cillian64/portfire/README.md

# portfire
Firework ignition control over ethernet

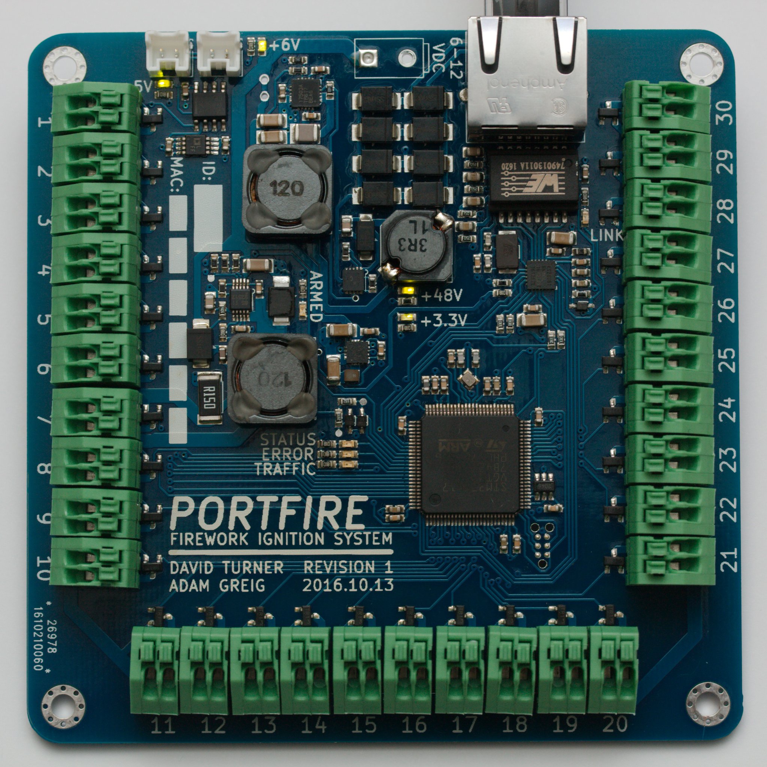
[picture p1: hardware/portfire_photo.jpg]
Photo of PCB


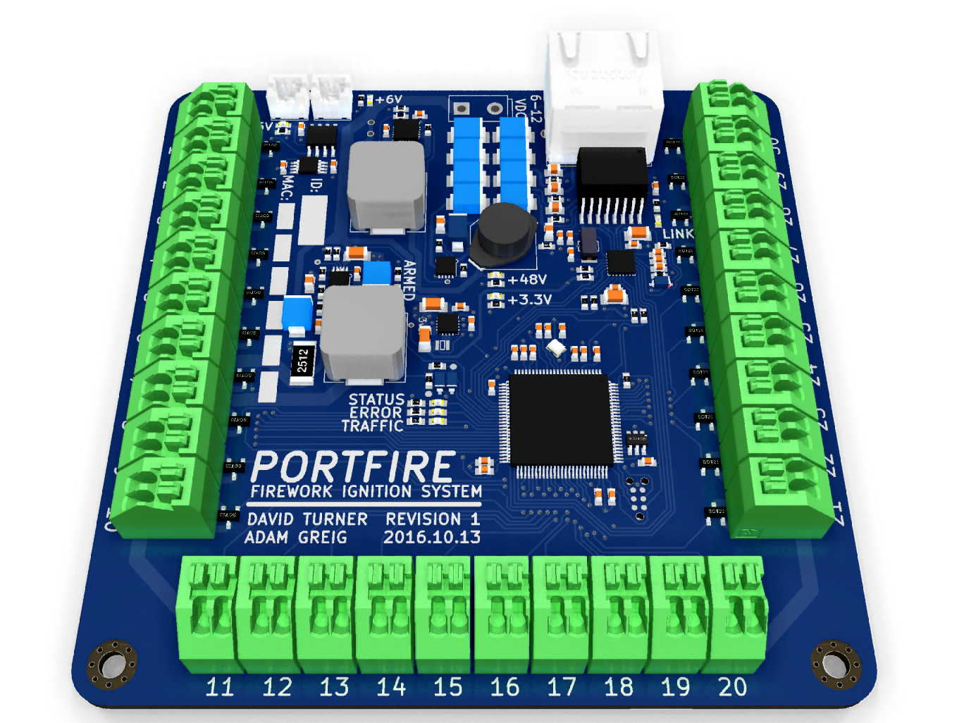
[picture p2: hardware/portfire_render.png]
3d render of PCB
