cillian64/portfire/case/hinged_lid/case_assembled.SLDASM

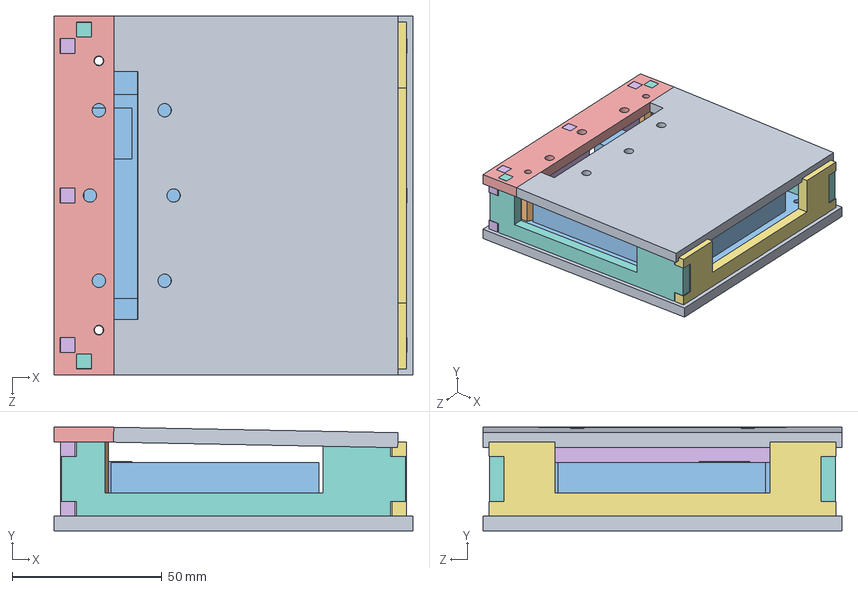
[picture p3: CAD file, 2016-11-16]
case/hinged_lid/case_assembled.SLDASM
120.0 x 34.6 x 120.0 mm
base_plate
hex_pillar x 2
pcb
spacer x 4
top_plate
side_ethernet
side_11-20
side_1-10_and_21-30 x 2
hinged_lid
