cillian64/portfire/case/hinged_lid/plots/side_ethernet.DXF

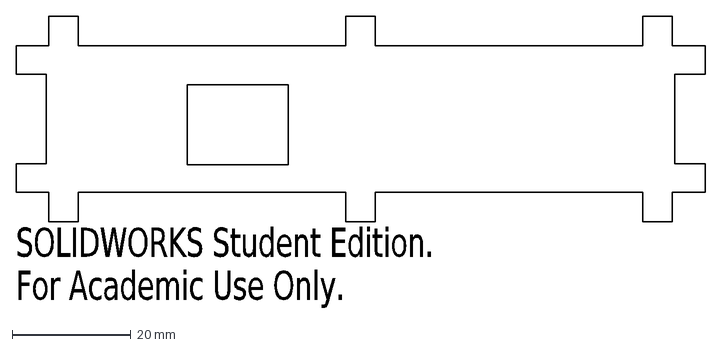
[picture p5: CAD file, 2016-11-16]
case/hinged_lid/plots/side_ethernet.DXF
SOLIDWORKS Student Edition.
For Academic Use Only.
