cillian64/portfire/case/hinged_lid/top_plate.SLDPRT

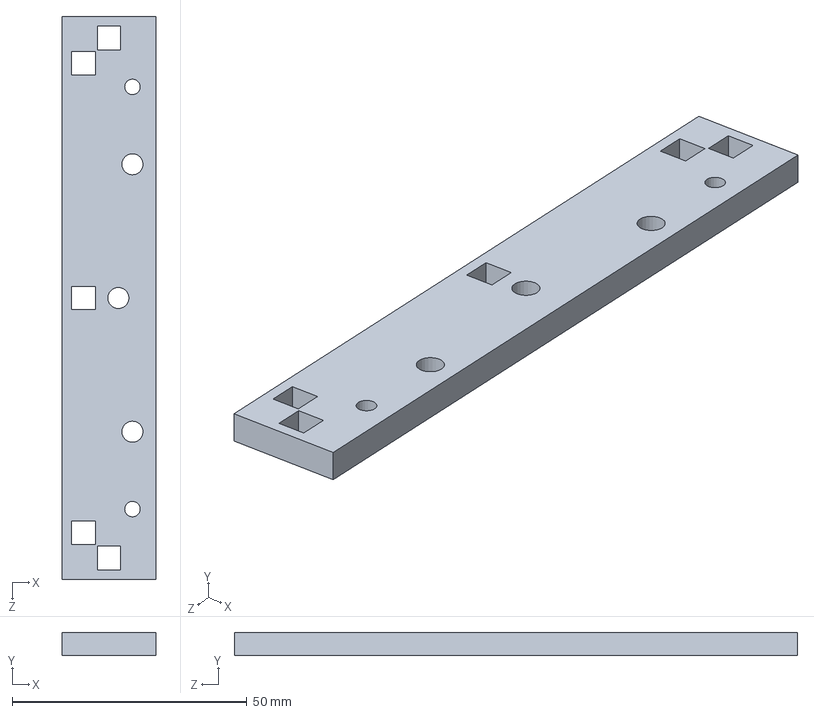
[picture p6: CAD file, 2016-11-16]
case/hinged_lid/top_plate.SLDPRT
20.0 x 5.00 x 120.0 mm
