cillian64/portfire/case/castellated_top/base_plate.SLDPRT

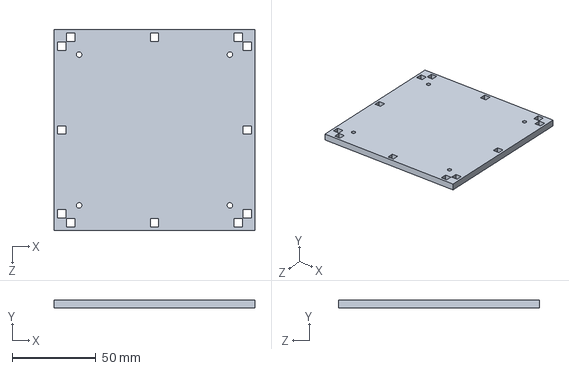
[picture p7: CAD file, 2016-11-12]
case/castellated_top/base_plate.SLDPRT
120.0 x 5.00 x 120.0 mm
