cillian64/portfire/case/hinged_lid/plots/side_11-20.DXF

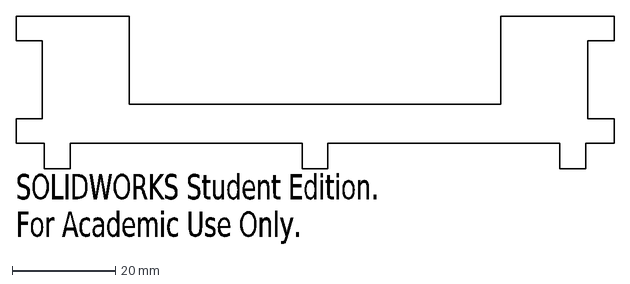
[picture p8: CAD file, 2016-11-16]
case/hinged_lid/plots/side_11-20.DXF
SOLIDWORKS Student Edition.
For Academic Use Only.
