cillian64/portfire/case/castellated_top/side_1-10_and_21-30.SLDPRT

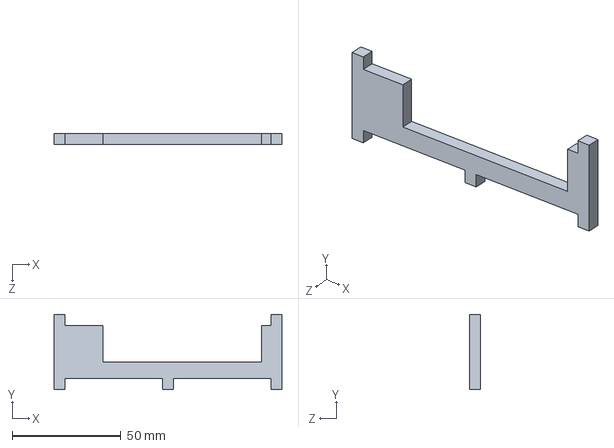
[picture p9: CAD file, 2016-11-12]
case/castellated_top/side_1-10_and_21-30.SLDPRT
105.0 x 34.6 x 5.00 mm
