cillian64/portfire/case/hinged_lid/hinged_lid.SLDPRT

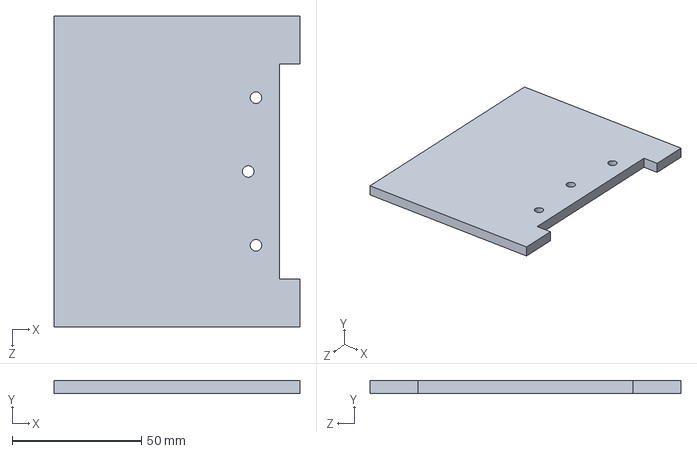
[picture p10: CAD file, 2016-11-16]
case/hinged_lid/hinged_lid.SLDPRT
95.0 x 5.00 x 120.0 mm
