cillian64/portfire/case/hinged_lid/plots/side_1-10_and_21-30.DXF

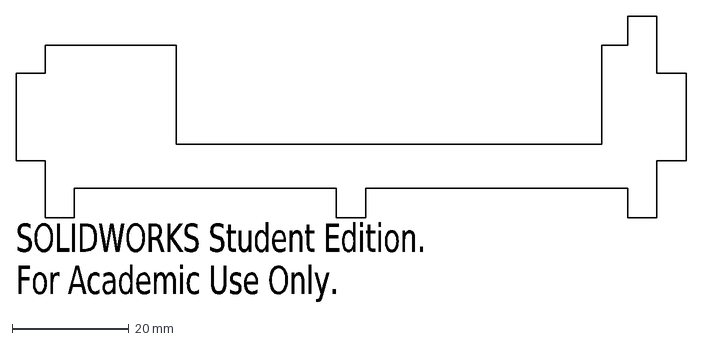
[picture p11: CAD file, 2016-11-16]
case/hinged_lid/plots/side_1-10_and_21-30.DXF
SOLIDWORKS Student Edition.
For Academic Use Only.
