cillian64/portfire/case/castellated_top/side_11-20.SLDPRT

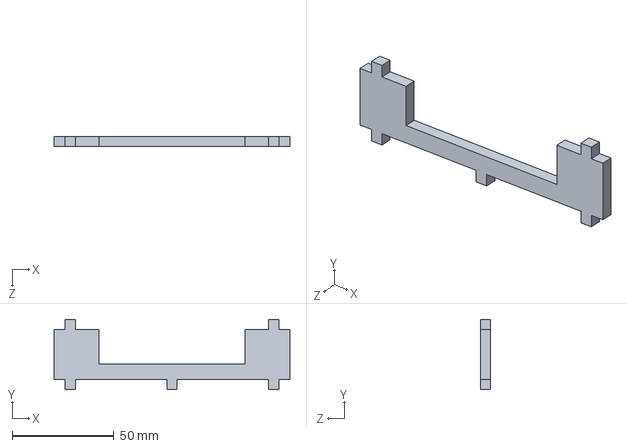
[picture p12: CAD file, 2016-11-12]
case/castellated_top/side_11-20.SLDPRT
116.0 x 34.6 x 5.00 mm
