cillian64/portfire/case/hinged_lid/plots/top_plate.DXF

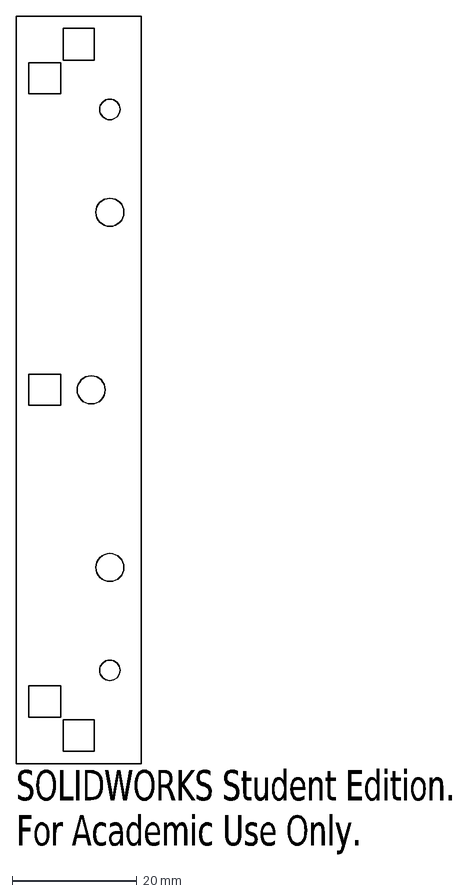
[picture p13: CAD file, 2016-11-16]
case/hinged_lid/plots/top_plate.DXF
SOLIDWORKS Student Edition.
For Academic Use Only.
