cillian64/portfire/case/hinged_lid/side_11-20.SLDPRT

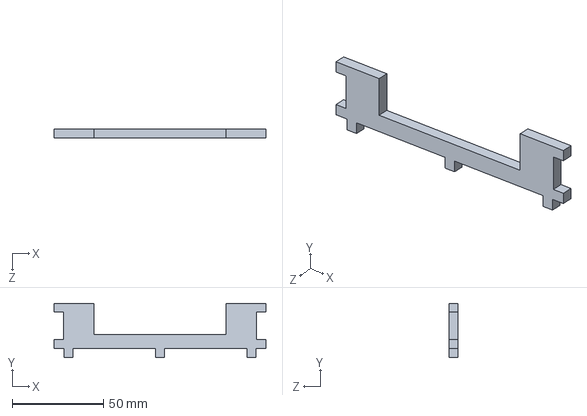
[picture p14: CAD file, 2016-11-12]
case/hinged_lid/side_11-20.SLDPRT
116.0 x 29.6 x 5.00 mm
