cillian64/portfire/case/castellated_top/pcb.SLDPRT

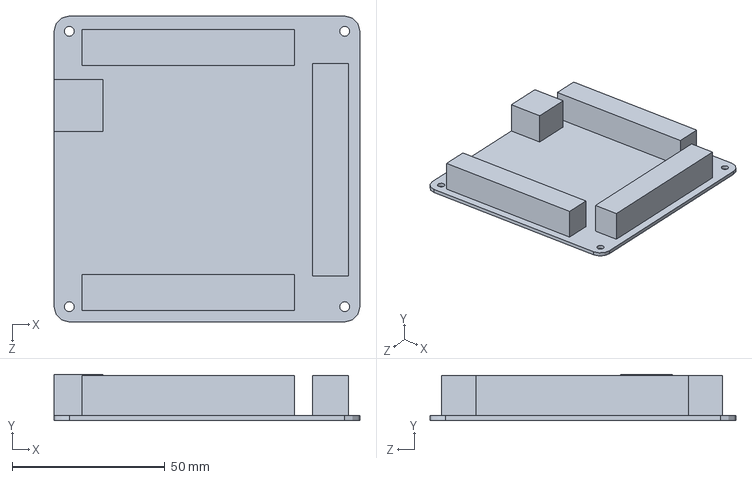
[picture p15: CAD file, 2016-11-12]
case/castellated_top/pcb.SLDPRT
100.0 x 15.1 x 100.0 mm
