cillian64/portfire/case/hinged_lid/plots/base_plate.DXF

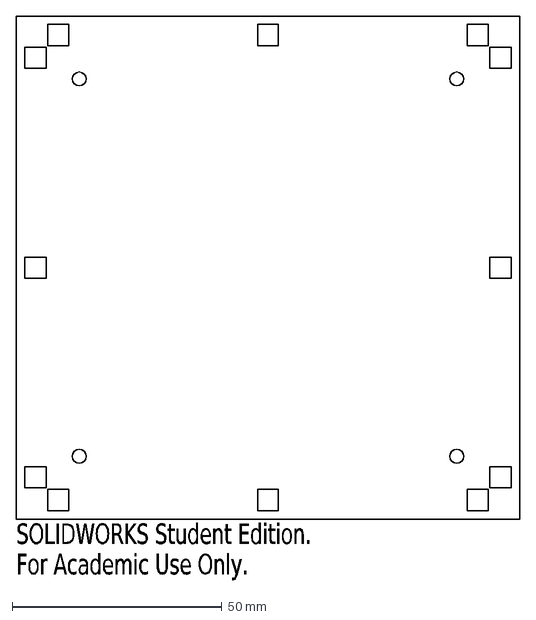
[picture p16: CAD file, 2016-11-16]
case/hinged_lid/plots/base_plate.DXF
SOLIDWORKS Student Edition.
For Academic Use Only.
