cillian64/portfire/case/hinged_lid/side_1-10_and_21-30.SLDPRT

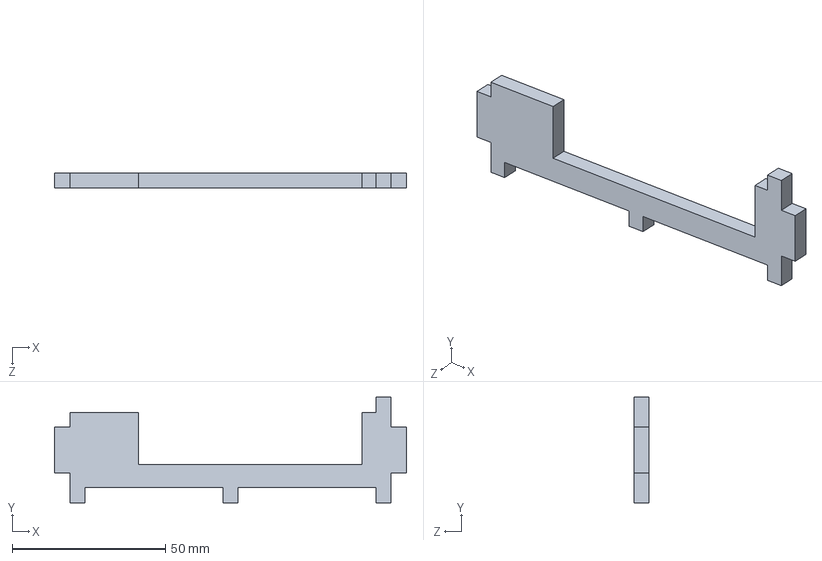
[picture p17: CAD file, 2016-11-12]
case/hinged_lid/side_1-10_and_21-30.SLDPRT
115.0 x 34.6 x 5.00 mm
