cillian64/portfire/case/hinged_lid/plots/hinged_lid.DXF

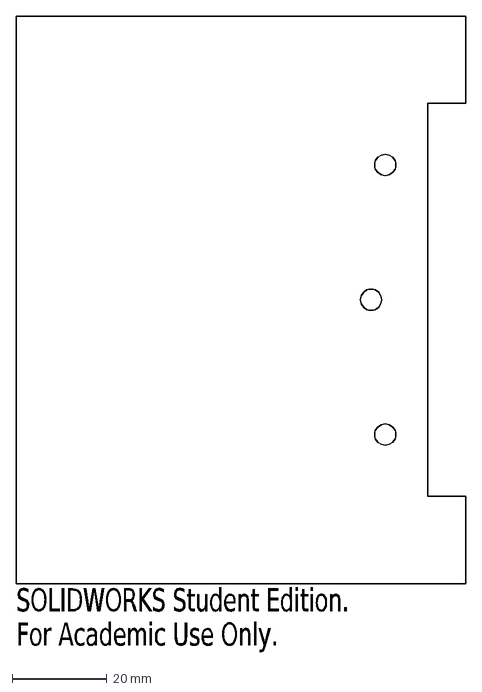
[picture p18: CAD file, 2016-11-16]
case/hinged_lid/plots/hinged_lid.DXF
SOLIDWORKS Student Edition.
For Academic Use Only.
