cillian64/portfire/case/castellated_top/side_ethernet.SLDPRT

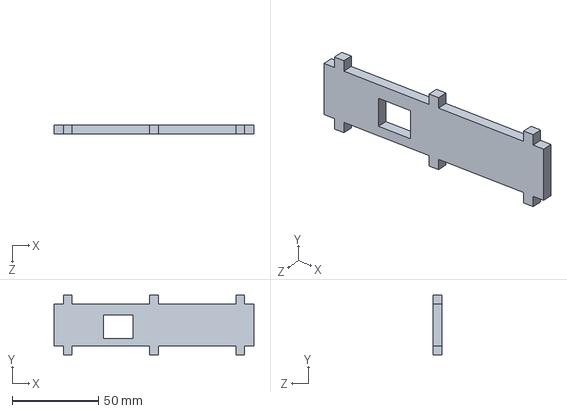
[picture p19: CAD file, 2016-11-12]
case/castellated_top/side_ethernet.SLDPRT
116.0 x 34.6 x 5.00 mm
