cillian64/portfire/case/hinged_lid/spacer.SLDPRT

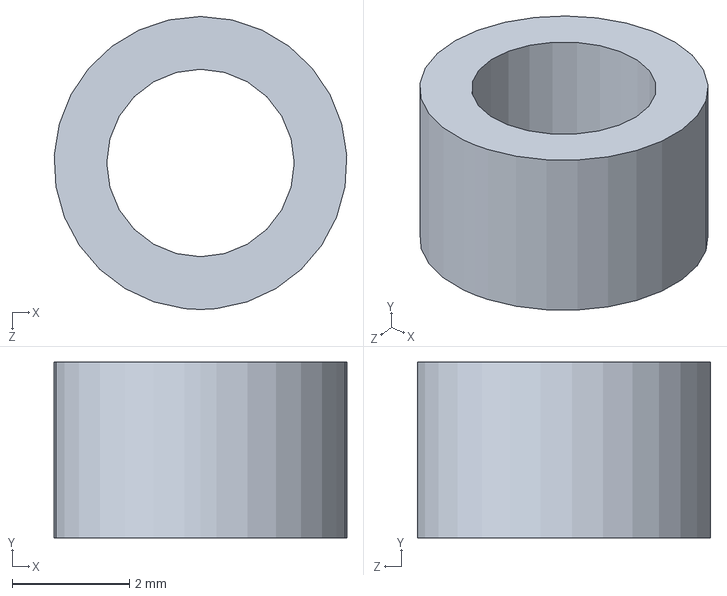
[picture p20: CAD file, 2016-11-12]
case/hinged_lid/spacer.SLDPRT
4.99 x 3.00 x 5.00 mm
