cillian64/portfire/case/hinged_lid/side_ethernet.SLDPRT

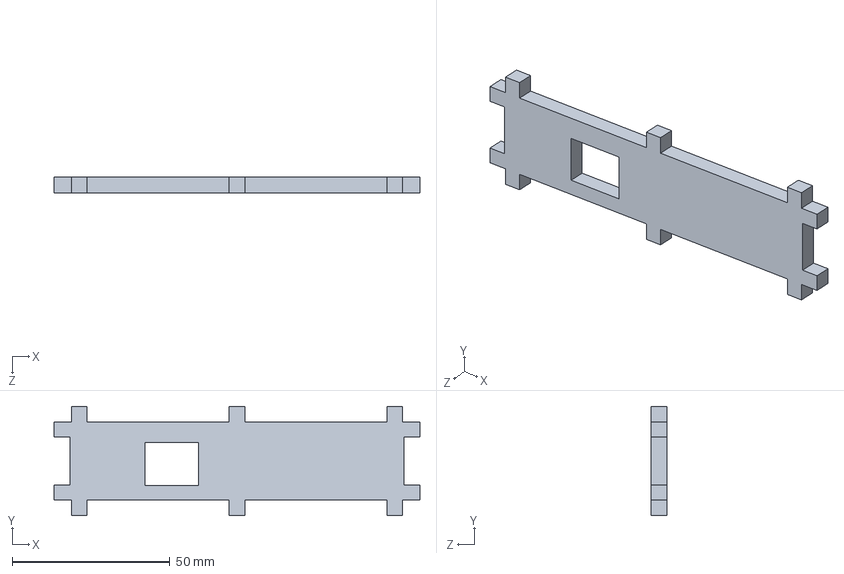
[picture p21: CAD file, 2016-11-12]
case/hinged_lid/side_ethernet.SLDPRT
116.0 x 34.6 x 5.00 mm
