cillian64/portfire/case/castellated_top/hex_pillar.SLDPRT

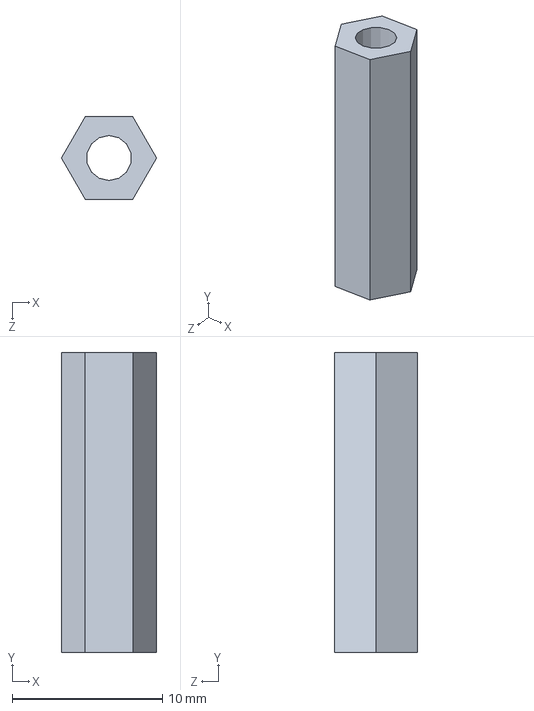
[picture p22: CAD file, 2016-11-12]
case/castellated_top/hex_pillar.SLDPRT
6.35 x 20.0 x 5.50 mm
