cillian64/portfire/(list of files, cad)

Other CAD files:
case/castellated_top/case_assembled.SLDASM
