cillian64/portfire/(threads)

Thread 3 (2016-11-24):

Board 003 doesn't work

adamgreig, 2016-11-24:
Some kind of manufacturing issue suspected.
