cillian64/portfire/hardware/portfire.kicad_pcb

## KiCad design hardware/portfire.kicad_pcb (2016-10-15)

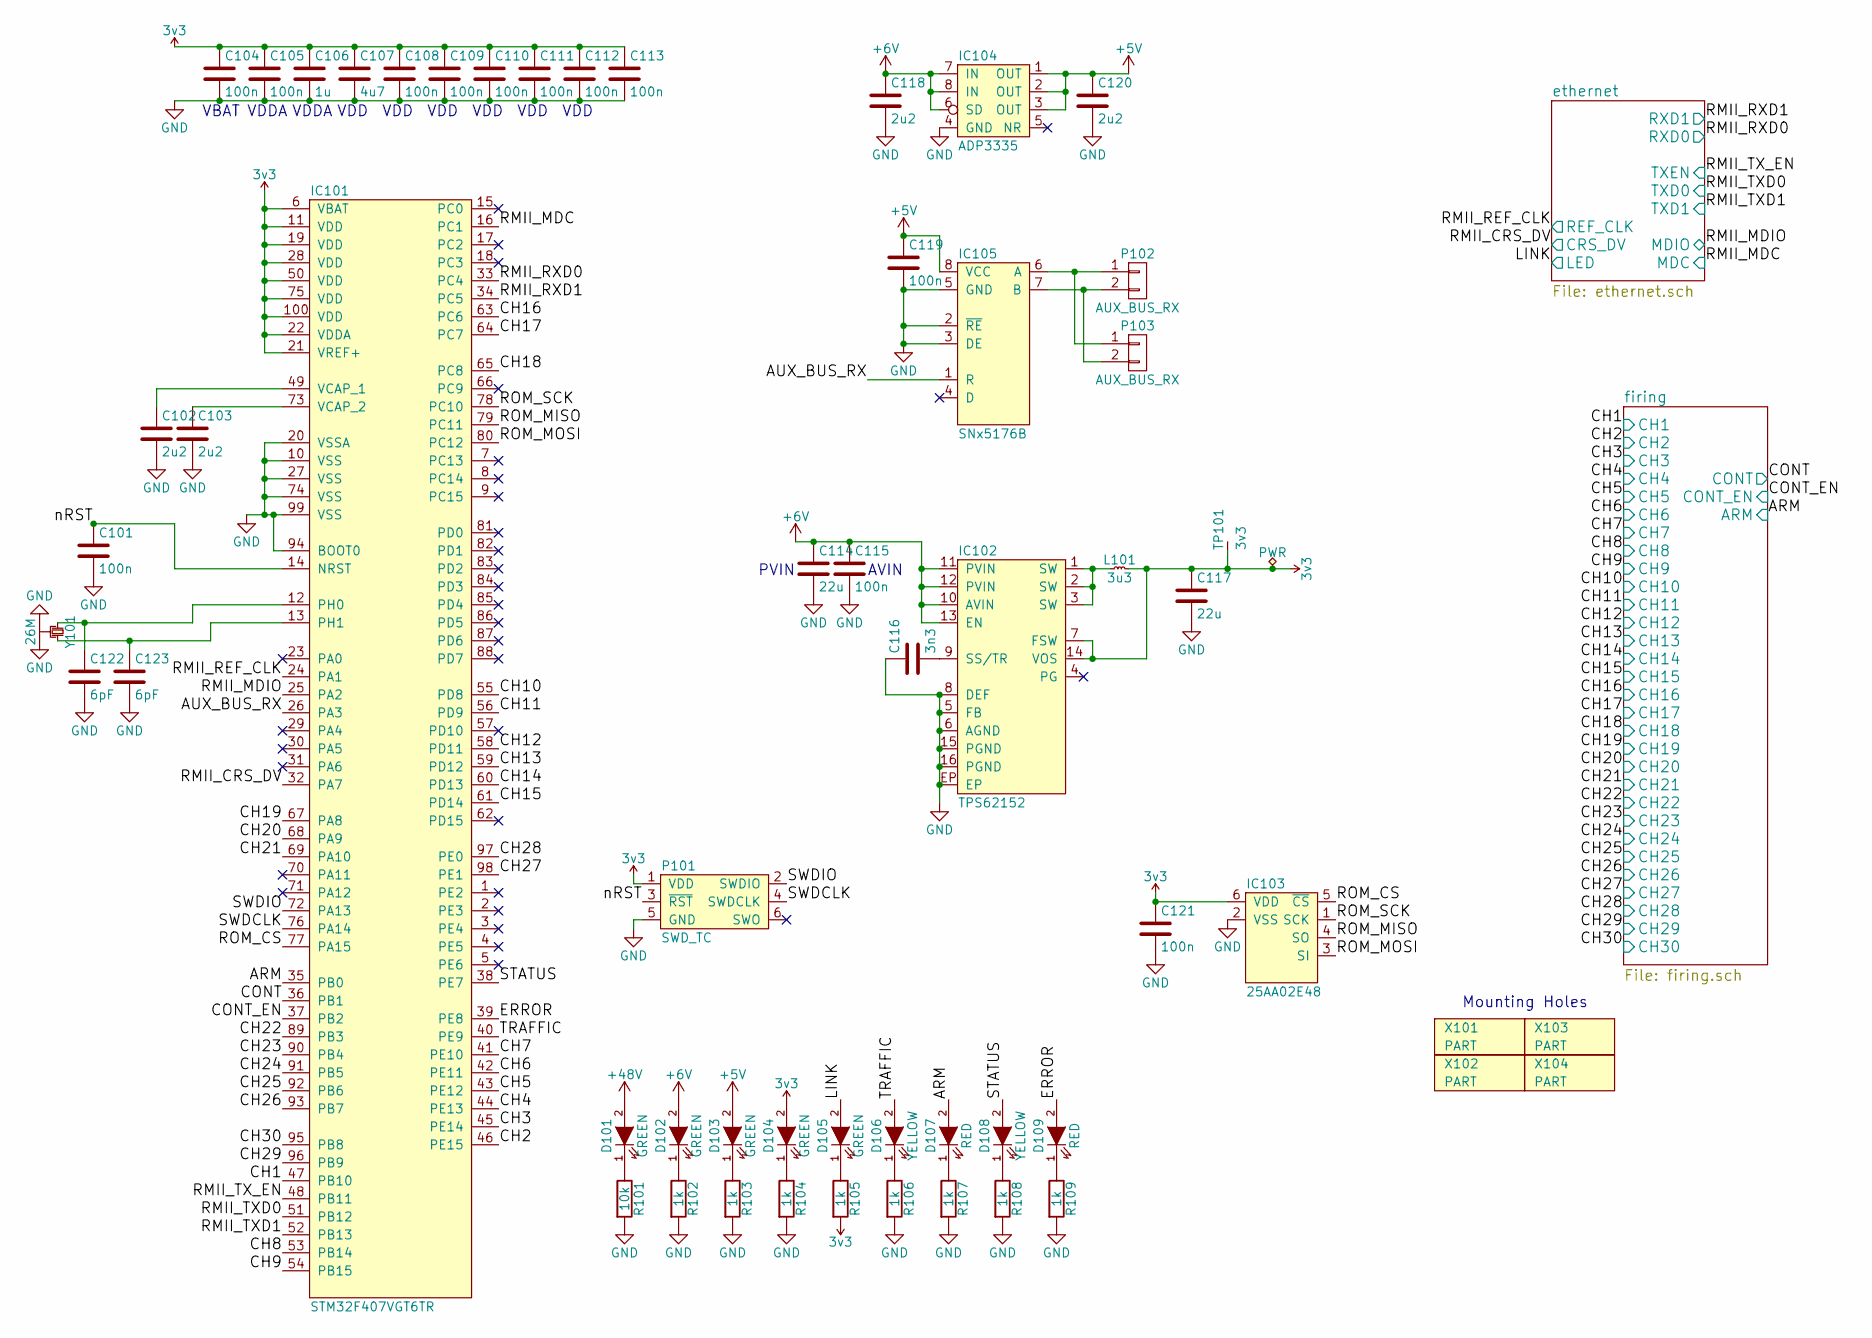
[picture p28: schematic portfire.sch]

Parts:
C101, C104, C105, C108, C109, C110, C111, C112, C113, C115, C119, C121: 100n; 0603; Farnell 1650835
C102, C103, C118, C120: 2u2; 0603; Farnell 2496923
C106: 1u; 0603; Farnell 9227776
C107: 4u7; 0603; Farnell 2496930
C114, C117: 22u; 1206; Farnell 1797010
C116: 3n3; 0603; Farnell 2496853
C122, C123: 6pF; 0603; Farnell 2525074
D101, D102, D103, D104, D105: GREEN; 0603-LED; Farnell 2290328
D106, D108: YELLOW; 0603-LED; Farnell 2290330
D107, D109: RED; 0603-LED; Farnell 2290329
IC101: STM32F407VGT6TR; LQFP-100; Farnell 2333297
IC102: TPS62152; QFN-16-EP-TI; Farnell 2382918
IC103: 25AA02E48; SOT-23-6; Farnell 1700995
IC104: ADP3335; MSOP-8; Farnell 2074873
IC105: SNx5176B; SOIC-8; Farnell 2395904
L101: 3u3; VLS201610HBX-1; Farnell 2455373
P101: SWD_TC; TC2030-NL
P102, P103: AUX_BUS_RX; B02B-PASK; Farnell 1830734
R101: 10k; 0603; Farnell 2303192
R102, R103, R104, R105, R106, R107, R108, R109: 1k; 0603; Farnell 9238484
TP101: 3v3; Test_point_mini
X101, X102, X103, X104: PART; M3_MOUNT
Y101: 26M; XTAL-20x16; Farnell 2455834

Connections:
3v3: C104.1, C105.1, C106.1, C107.1, C108.1, C109.1, C110.1, C111.1, C112.1, C113.1, C117.1, C121.1, D104.2 (A), IC101.6 (VBAT), IC101.11 (VDD), IC101.19 (VDD), IC101.21 (VREF+), IC101.22 (VDDA), IC101.28 (VDD), IC101.50 (VDD), IC101.75 (VDD), IC101.100 (VDD), IC102.7 (FSW), IC102.14 (VOS), IC103.6 (VDD), L101.2, P101.1 (VDD), R105.2, TP101.1; also elsewhere on the board
+5V: C119.1, C120.1, D103.2 (A), IC104.1 (OUT), IC104.2 (OUT), IC104.3 (OUT), IC105.8 (VCC)
+6V: C114.1, C115.1, C118.1, D102.2 (A), IC102.10 (AVIN), IC102.11 (PVIN), IC102.12 (PVIN), IC102.13 (EN), IC104.6 (SD), IC104.7 (IN), IC104.8 (IN); also elsewhere on the board
+48V: D101.2 (A); also elsewhere on the board
/ARM: D107.2 (A), IC101.35 (PB0); also elsewhere on the board
/AUX_BUS_RX: IC101.26 (PA3), IC105.1 (R)
/CH1: IC101.47 (PB10); also elsewhere on the board
/CH2: IC101.46 (PE15); also elsewhere on the board
/CH3: IC101.45 (PE14); also elsewhere on the board
/CH4: IC101.44 (PE13); also elsewhere on the board
/CH5: IC101.43 (PE12); also elsewhere on the board
/CH6: IC101.42 (PE11); also elsewhere on the board
/CH7: IC101.41 (PE10); also elsewhere on the board
/CH8: IC101.53 (PB14); also elsewhere on the board
/CH9: IC101.54 (PB15); also elsewhere on the board
/CH10: IC101.55 (PD8); also elsewhere on the board
/CH11: IC101.56 (PD9); also elsewhere on the board
/CH12: IC101.58 (PD11); also elsewhere on the board
/CH13: IC101.59 (PD12); also elsewhere on the board
/CH14: IC101.60 (PD13); also elsewhere on the board
/CH15: IC101.61 (PD14); also elsewhere on the board
/CH16: IC101.63 (PC6); also elsewhere on the board
/CH17: IC101.64 (PC7); also elsewhere on the board
/CH18: IC101.65 (PC8); also elsewhere on the board
/CH19: IC101.67 (PA8); also elsewhere on the board
/CH20: IC101.68 (PA9); also elsewhere on the board
/CH21: IC101.69 (PA10); also elsewhere on the board
/CH22: IC101.89 (PB3); also elsewhere on the board
/CH23: IC101.90 (PB4); also elsewhere on the board
/CH24: IC101.91 (PB5); also elsewhere on the board
/CH25: IC101.92 (PB6); also elsewhere on the board
/CH26: IC101.93 (PB7); also elsewhere on the board
/CH27: IC101.98 (PE1); also elsewhere on the board
/CH28: IC101.97 (PE0); also elsewhere on the board
/CH29: IC101.96 (PB9); also elsewhere on the board
/CH30: IC101.95 (PB8); also elsewhere on the board
/CONT: IC101.36 (PB1); also elsewhere on the board
/CONT_EN: IC101.37 (PB2); also elsewhere on the board
/ERROR: D109.2 (A), IC101.39 (PE8)
/LINK: D105.2 (A); also elsewhere on the board
/RMII_CRS_DV: IC101.32 (PA7); also elsewhere on the board
/RMII_MDC: IC101.16 (PC1); also elsewhere on the board
/RMII_MDIO: IC101.25 (PA2); also elsewhere on the board
/RMII_REF_CLK: IC101.24 (PA1); also elsewhere on the board
/RMII_RXD0: IC101.33 (PC4); also elsewhere on the board
/RMII_RXD1: IC101.34 (PC5); also elsewhere on the board
/RMII_TXD0: IC101.51 (PB12); also elsewhere on the board
/RMII_TXD1: IC101.52 (PB13); also elsewhere on the board
/RMII_TX_EN: IC101.48 (PB11); also elsewhere on the board
/ROM_CS: IC101.77 (PA15), IC103.5 (~CS)
/ROM_MISO: IC101.79 (PC11), IC103.4 (SO)
/ROM_MOSI: IC101.80 (PC12), IC103.3 (SI)
/ROM_SCK: IC101.78 (PC10), IC103.1 (SCK)
/STATUS: D108.2 (A), IC101.38 (PE7)
/SWDCLK: IC101.76 (PA14), P101.4 (SWDCLK)
/SWDIO: IC101.72 (PA13), P101.2 (SWDIO)
/TRAFFIC: D106.2 (A), IC101.40 (PE9)
/nRST: C101.1, IC101.14 (NRST), P101.3 (~RST)
GND: C101.2, C102.2, C103.2, C104.2, C105.2, C106.2, C107.2, C108.2, C109.2, C110.2, C111.2, C112.2, C113.2, C114.2, C115.2, C116.1, C117.2, C118.2, C119.2, C120.2, C121.2, C122.2, C123.2, IC101.10 (VSS), IC101.20 (VSSA), IC101.27 (VSS), IC101.74 (VSS), IC101.94 (BOOT0), IC101.99 (VSS), IC102.5 (FB), IC102.6 (AGND), IC102.8 (DEF), IC102.15 (PGND), IC102.16 (PGND), IC102.EP, IC103.2 (VSS), IC104.4 (GND), IC105.2 (~RE), IC105.3 (DE), IC105.5 (GND), P101.5 (GND), R101.2, R102.2, R103.2, R104.2, R106.2, R107.2, R108.2, R109.2, Y101.2, Y101.4; also elsewhere on the board
unnamed: C102.1, IC101.49 (VCAP_1)
unnamed: C103.1, IC101.73 (VCAP_2)
unnamed: C116.2, IC102.9 (SS/TR)
unnamed: C122.1, IC101.12 (PH0), Y101.1
unnamed: C123.1, IC101.13 (PH1), Y101.3
unnamed: D101.1 (K), R101.1
unnamed: D102.1 (K), R102.1
unnamed: D103.1 (K), R103.1
unnamed: D104.1 (K), R104.1
unnamed: D105.1 (K), R105.1
unnamed: D106.1 (K), R106.1
unnamed: D107.1 (K), R107.1
unnamed: D108.1 (K), R108.1
unnamed: D109.1 (K), R109.1
unnamed: IC102.1 (SW), IC102.2 (SW), IC102.3 (SW), L101.1
unnamed: IC105.6 (A), P102.1, P103.1
unnamed: IC105.7 (B), P102.2, P103.2

Notes on the sheet:
PVIN
AVIN
VBAT
VDDA
VDD
Mounting Holes

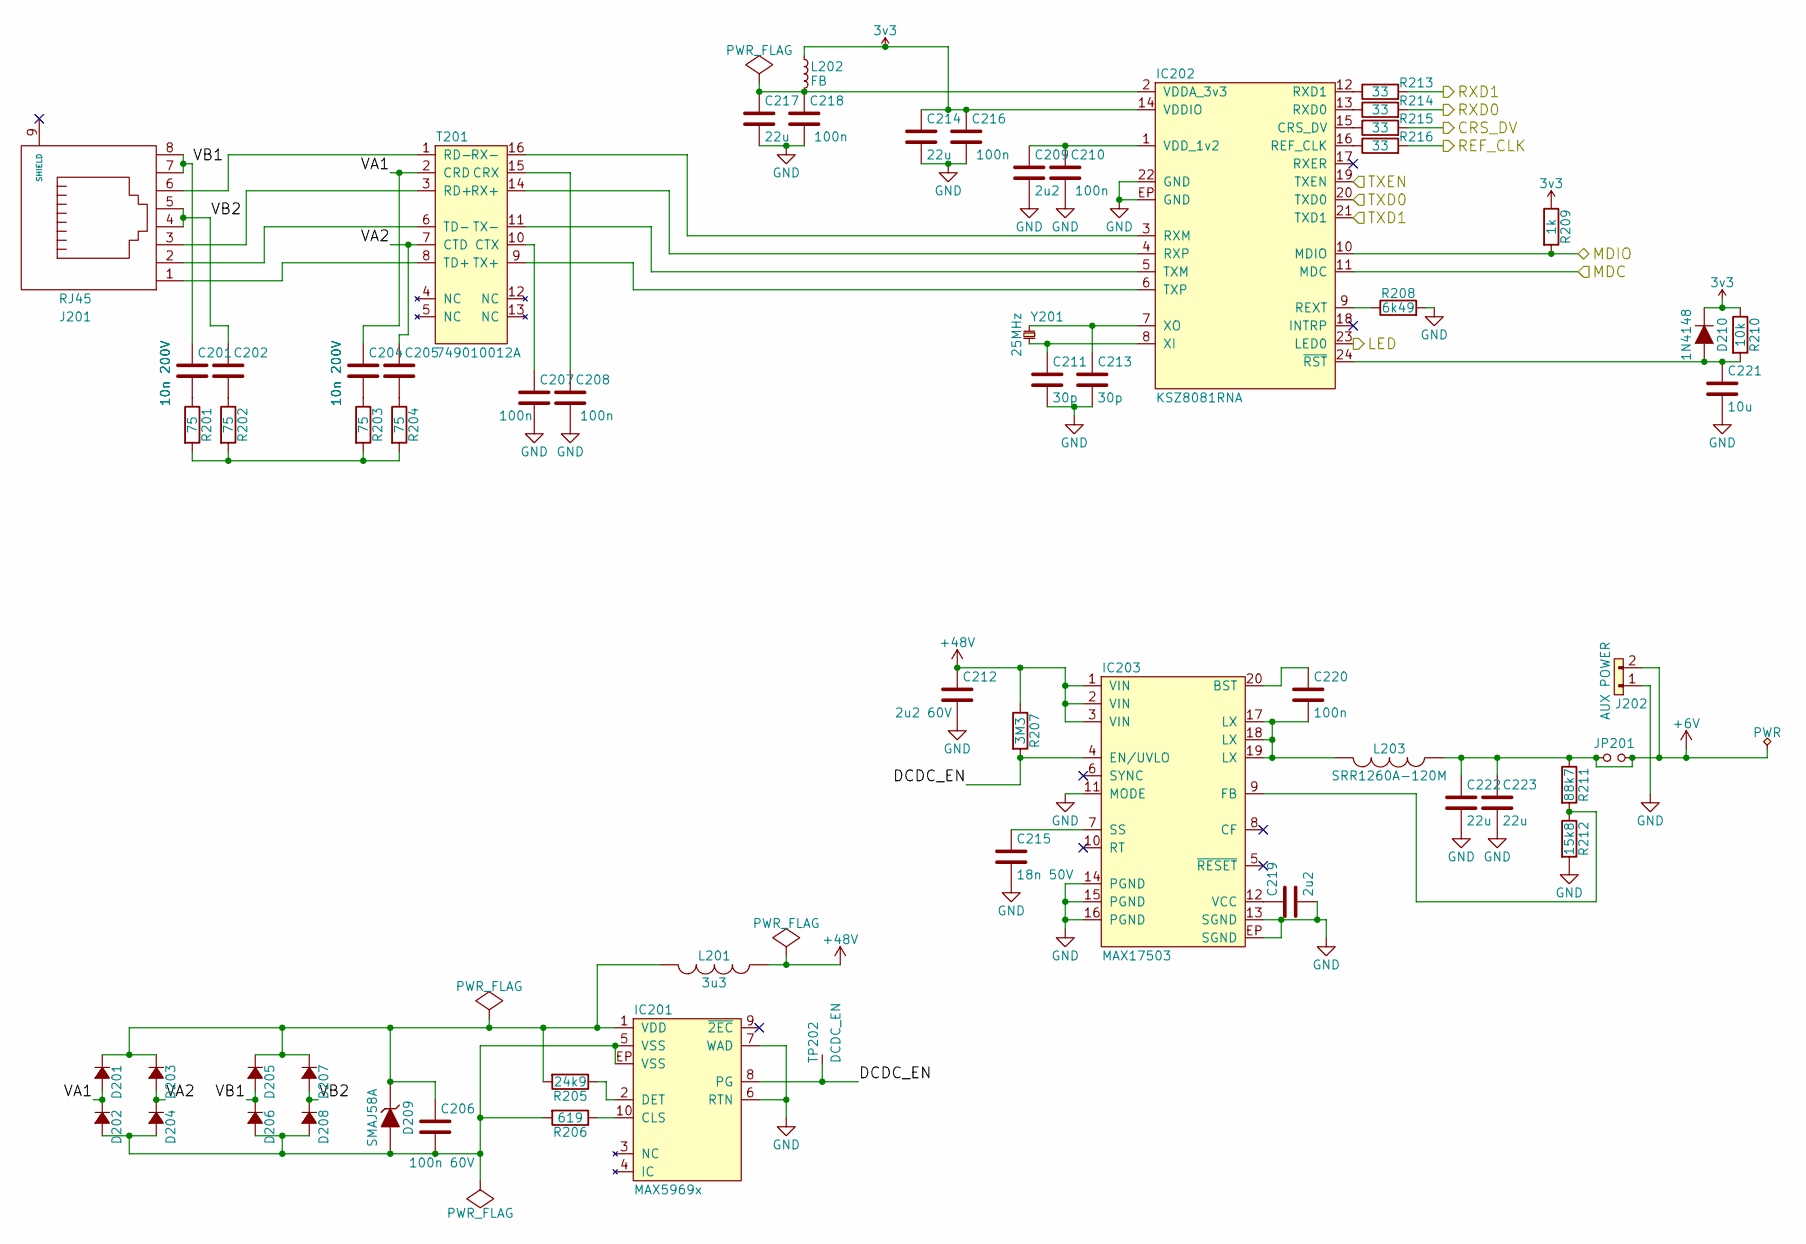
[picture p29: schematic ethernet.sch, Portfire]

Parts:
C201, C202, C204, C205: 10n 200V; 0805; Farnell 1828955
C206: 100n 60V; 0805; Farnell 2496941
C207, C208, C210, C216, C218, C220: 100n; 0603; Farnell 1650835
C209, C219: 2u2; 0603; Farnell 2496923
C211, C213: 30p; 0603; Farnell 2524889
C212: 2u2 60V; 1210; Farnell 1793832
C214, C217, C222, C223: 22u; 1206; Farnell 1797010
C215: 18n 50V; 0603; Farnell 1865536
C221: 10u; 0603; Farnell 2611921
D201, D202, D203, D204, D205, D206, D207, D208: SS110B; DO-214AA-SMB; Farnell 1861422
D209: SMAJ58A; DO-214AC-SMA; Farnell 1899460
D210: 1N4148; SOD-323; Farnell 1466524
IC201: MAX5969x; DFN-10-EP-MAX; Farnell 2514586
IC202: KSZ8081RNA; QFN-24-EP-MICREL; Farnell 2509802
IC203: MAX17503; QFN-20-EP-MAX; Farnell 2514229
J201: RJ45; RJHSE5380; Farnell 1860580
J202: AUX POWER; Minipow; Farnell CN13861
JP201: Jumper_NO_Small; jump
L201: 3u3; ELLATP3R3NB; Farnell 1865686
L202: FB; 0603; Farnell 1463451
L203: SRR1260A-120M; SRR1260A; Farnell 2374123
R201, R202, R203, R204: 75; 0603; Farnell 2059571
R205: 24k9; 0603; Farnell 2059450
R206: 619; 0603; Farnell 2059317
R207: 3M3; 0603; Farnell 2138666
R208: 6k49; 0603; Farnell 2059389
R209: 1k; 0603; Farnell 9238484
R210: 10k; 0603; Farnell 2303192
R211: 88k7; 0603; Farnell 2059491
R212: 15k8; 0603; Farnell 2138432
R213, R214, R215, R216: 33; 0603; Farnell 2059561
T201: 749010012A; Farnell 2422552
TP202: DCDC_EN; Test_point_mini
Y201: 25MHz; XTAL-50x32; Farnell 2101328

Connections:
3v3: C214.1, C216.1, D210.1 (K), IC202.14 (VDDIO), L202.1, R209.1, R210.1; also elsewhere on the board
+6V: C222.1, C223.1, J202.2, JP201.1, JP201.2, L203.1, R211.1; also elsewhere on the board
+48V: C212.1, IC203.1 (VIN), IC203.2 (VIN), IC203.3 (VIN), L201.1, R207.1; also elsewhere on the board
/LINK: IC202.23 (LED0); also elsewhere on the board
/RMII_CRS_DV: R215.2; also elsewhere on the board
/RMII_MDC: IC202.11 (MDC); also elsewhere on the board
/RMII_MDIO: IC202.10 (MDIO), R209.2; also elsewhere on the board
/RMII_REF_CLK: R216.2; also elsewhere on the board
/RMII_RXD0: R214.2; also elsewhere on the board
/RMII_RXD1: R213.2; also elsewhere on the board
/RMII_TXD0: IC202.20 (TXD0); also elsewhere on the board
/RMII_TXD1: IC202.21 (TXD1); also elsewhere on the board
/RMII_TX_EN: IC202.19 (TXEN); also elsewhere on the board
/ethernet/DCDC_EN: IC201.8 (PG), IC203.4 (EN/UVLO), R207.2, TP202.1
/ethernet/VA1: C204.1, D201.2 (A), D202.1 (K), T201.2 (CRD)
/ethernet/VA2: C205.1, D203.2 (A), D204.1 (K), T201.7 (CTD)
/ethernet/VB1: C201.1, D205.2 (A), D206.1 (K), J201.7, J201.8
/ethernet/VB2: C202.1, D207.2 (A), D208.1 (K), J201.4, J201.5
GND: C207.2, C208.2, C209.2, C210.2, C211.2, C212.2, C213.2, C214.2, C215.2, C216.2, C217.2, C218.2, C219.2, C221.2, C222.2, C223.2, IC201.6 (RTN), IC201.7 (WAD), IC202.22 (GND), IC202.EP (GND), IC203.11 (MODE), IC203.13 (SGND), IC203.14 (PGND), IC203.15 (PGND), IC203.16 (PGND), IC203.EP (SGND), J202.1, R208.2, R212.2; also elsewhere on the board
unnamed: C201.2, R201.1
unnamed: C202.2, R202.1
unnamed: C204.2, R203.1
unnamed: C205.2, R204.1
unnamed: C206.1, D201.1 (K), D203.1 (K), D205.1 (K), D207.1 (K), D209.1 (K), IC201.1 (VDD), L201.2, R205.2
unnamed: C206.2, D202.2 (A), D204.2 (A), D206.2 (A), D208.2 (A), D209.2 (A), IC201.5 (VSS), IC201.EP (VSS), R206.2
unnamed: C207.1, T201.10 (CTX)
unnamed: C208.1, T201.15 (CRX)
unnamed: C209.1, C210.1, IC202.1 (VDD_1v2)
unnamed: C211.1, IC202.8 (XI), Y201.2
unnamed: C213.1, IC202.7 (XO), Y201.1
unnamed: C215.1, IC203.7 (SS)
unnamed: C217.1, C218.1, IC202.2 (VDDA_3v3), L202.2
unnamed: C219.1, IC203.12 (VCC)
unnamed: C220.1, IC203.20 (BST)
unnamed: C220.2, IC203.17 (LX), IC203.18 (LX), IC203.19 (LX), L203.2
unnamed: C221.1, D210.2 (A), IC202.24 (~RST), R210.2
unnamed: IC201.2 (DET), R205.1
unnamed: IC201.10 (CLS), R206.1
unnamed: IC202.3 (RXM), T201.16 (RX-)
unnamed: IC202.4 (RXP), T201.14 (RX+)
unnamed: IC202.5 (TXM), T201.11 (TX-)
unnamed: IC202.6 (TXP), T201.9 (TX+)
unnamed: IC202.9 (REXT), R208.1
unnamed: IC202.12 (RXD1), R213.1
unnamed: IC202.13 (RXD0), R214.1
unnamed: IC202.15 (CRS_DV), R215.1
unnamed: IC202.16 (REF_CLK), R216.1
unnamed: IC203.9 (FB), R211.2, R212.1
unnamed: J201.1, T201.8 (TD+)
unnamed: J201.2, T201.6 (TD-)
unnamed: J201.3, T201.3 (RD+)
unnamed: J201.6, T201.1 (RD-)
unnamed: R201.2, R202.2, R203.2, R204.2

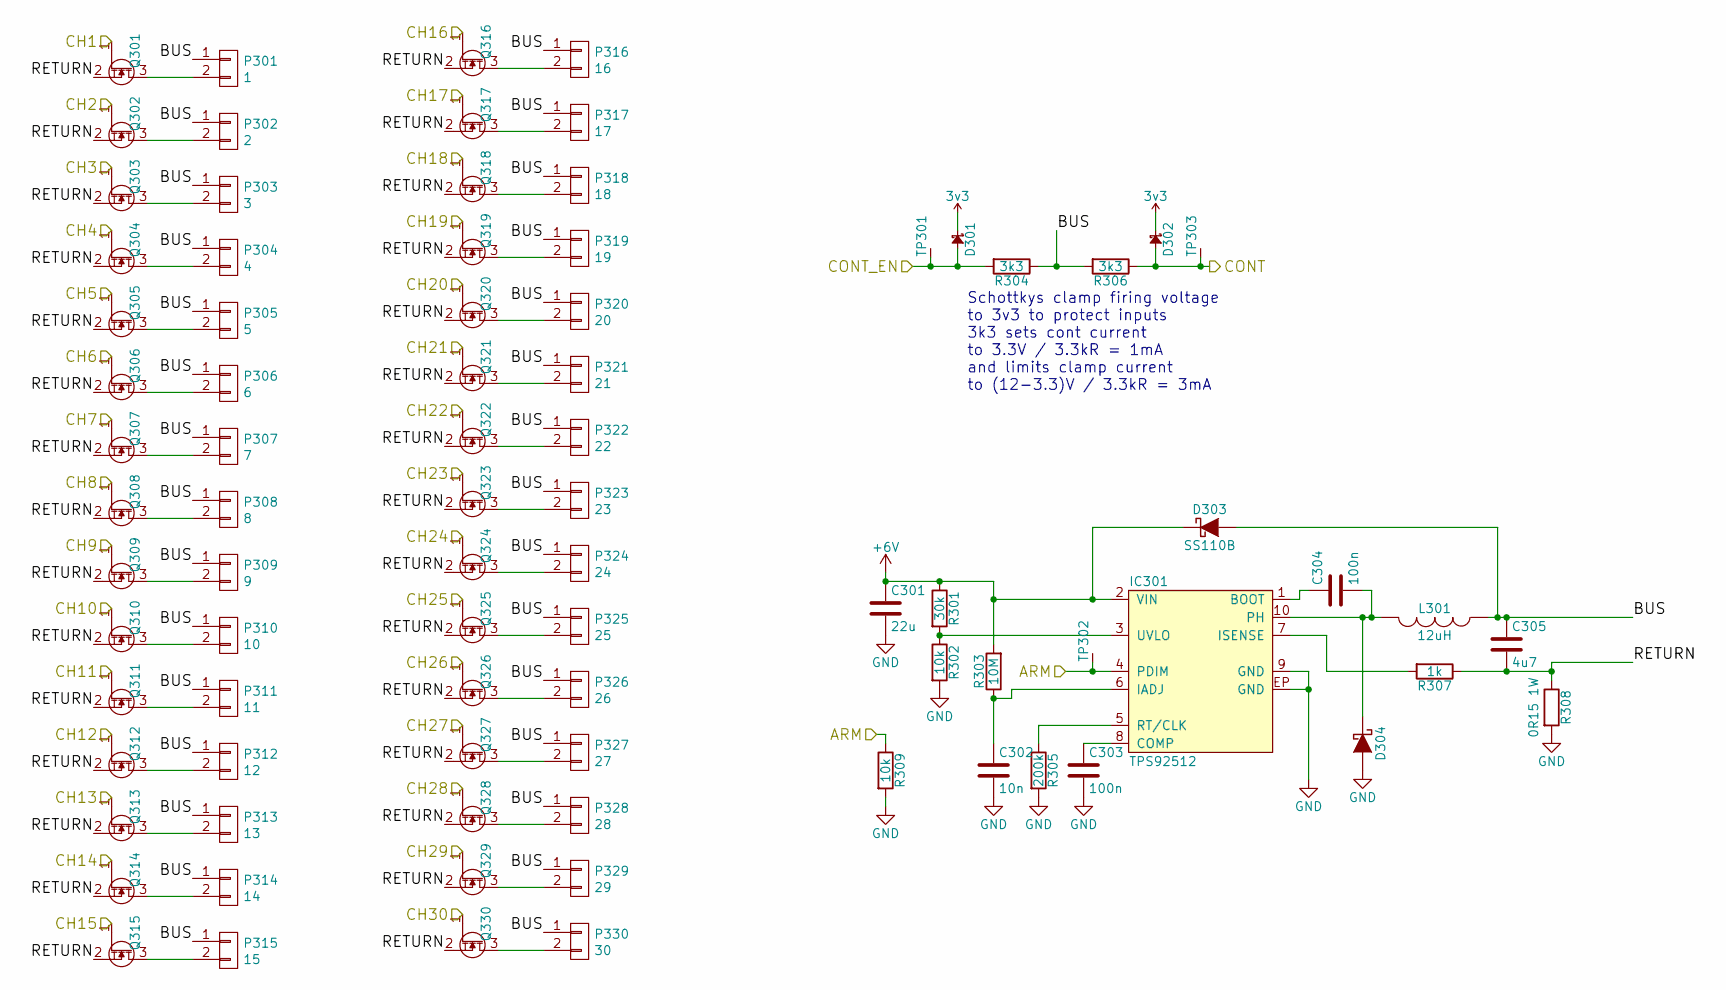
[picture p30: schematic firing.sch, Portfire]

Parts:
C301: 22u; 1206; Farnell 1797010
C302: 10n; 0805; Farnell 1828955
C303, C304: 100n; 0603; Farnell 1650835
C305: 4u7; 0603; Farnell 2525102
D301, D302: PMEG2005AEA; SOD-323; Farnell 8737843
D303: SS110B; DO-214AA-SMB; Farnell 1861422
D304: STPS3L40UF; DO-214AA-SMB; Farnell 2341599
IC301: TPS92512; MSOP-10-EP-TI; Farnell 2471141
L301: 12uH; SRR1260A; Farnell 2374123
P301: 1; PTSA0,52-2,5-z; Farnell 1792951
P302: 2; PTSA0,52-2,5-z; Farnell 1792951
P303: 3; PTSA0,52-2,5-z; Farnell 1792951
P304: 4; PTSA0,52-2,5-z; Farnell 1792951
P305: 5; PTSA0,52-2,5-z; Farnell 1792951
P306: 6; PTSA0,52-2,5-z; Farnell 1792951
P307: 7; PTSA0,52-2,5-z; Farnell 1792951
P308: 8; PTSA0,52-2,5-z; Farnell 1792951
P309: 9; PTSA0,52-2,5-z; Farnell 1792951
P310: 10; PTSA0,52-2,5-z; Farnell 1792951
P311: 11; PTSA0,52-2,5-z; Farnell 1792951
P312: 12; PTSA0,52-2,5-z; Farnell 1792951
P313: 13; PTSA0,52-2,5-z; Farnell 1792951
P314: 14; PTSA0,52-2,5-z; Farnell 1792951
P315: 15; PTSA0,52-2,5-z; Farnell 1792951
P316: 16; PTSA0,52-2,5-z; Farnell 1792951
P317: 17; PTSA0,52-2,5-z; Farnell 1792951
P318: 18; PTSA0,52-2,5-z; Farnell 1792951
P319: 19; PTSA0,52-2,5-z; Farnell 1792951
P320: 20; PTSA0,52-2,5-z; Farnell 1792951
P321: 21; PTSA0,52-2,5-z; Farnell 1792951
P322: 22; PTSA0,52-2,5-z; Farnell 1792951
P323: 23; PTSA0,52-2,5-z; Farnell 1792951
P324: 24; PTSA0,52-2,5-z; Farnell 1792951
P325: 25; PTSA0,52-2,5-z; Farnell 1792951
P326: 26; PTSA0,52-2,5-z; Farnell 1792951
P327: 27; PTSA0,52-2,5-z; Farnell 1792951
P328: 28; PTSA0,52-2,5-z; Farnell 1792951
P329: 29; PTSA0,52-2,5-z; Farnell 1792951
P330: 30; PTSA0,52-2,5-z; Farnell 1792951
Q301, Q302, Q303, Q304, Q305, Q306, Q307, Q308, Q309, Q310, Q311, Q312, Q313, Q314, Q315, Q316, Q317, Q318, Q319, Q320, Q321, Q322, Q323, Q324, Q325, Q326, Q327, Q328, Q329, Q330: NTR4501NT1G; SOT-23; Farnell 1431305
R301: 30k; 0603; Farnell 2059451
R302, R309: 10k; 0603; Farnell 2303192
R303: 10M; 0603; Farnell 2059699
R304, R306: 3k3; 0603; Farnell 2059614
R305: 200k; 0603; Farnell 2059509
R307: 1k; 0603; Farnell 9238484
R308: 0R15 1W; 2512; Farnell 2116453
TP301: CONT_EN; TESTPAD
TP302: ARM; TESTPAD
TP303: CONT_MEAS; TESTPAD

Connections:
3v3: D301.1, D302.1; also elsewhere on the board
+6V: C301.1, D303.1 (K), IC301.2 (VIN), R301.1, R303.2; also elsewhere on the board
/ARM: IC301.4 (PDIM), R309.1, TP302.1; also elsewhere on the board
/CH1: Q301.1 (G); also elsewhere on the board
/CH2: Q302.1 (G); also elsewhere on the board
/CH3: Q303.1 (G); also elsewhere on the board
/CH4: Q304.1 (G); also elsewhere on the board
/CH5: Q305.1 (G); also elsewhere on the board
/CH6: Q306.1 (G); also elsewhere on the board
/CH7: Q307.1 (G); also elsewhere on the board
/CH8: Q308.1 (G); also elsewhere on the board
/CH9: Q309.1 (G); also elsewhere on the board
/CH10: Q310.1 (G); also elsewhere on the board
/CH11: Q311.1 (G); also elsewhere on the board
/CH12: Q312.1 (G); also elsewhere on the board
/CH13: Q313.1 (G); also elsewhere on the board
/CH14: Q314.1 (G); also elsewhere on the board
/CH15: Q315.1 (G); also elsewhere on the board
/CH16: Q316.1 (G); also elsewhere on the board
/CH17: Q317.1 (G); also elsewhere on the board
/CH18: Q318.1 (G); also elsewhere on the board
/CH19: Q319.1 (G); also elsewhere on the board
/CH20: Q320.1 (G); also elsewhere on the board
/CH21: Q321.1 (G); also elsewhere on the board
/CH22: Q322.1 (G); also elsewhere on the board
/CH23: Q323.1 (G); also elsewhere on the board
/CH24: Q324.1 (G); also elsewhere on the board
/CH25: Q325.1 (G); also elsewhere on the board
/CH26: Q326.1 (G); also elsewhere on the board
/CH27: Q327.1 (G); also elsewhere on the board
/CH28: Q328.1 (G); also elsewhere on the board
/CH29: Q329.1 (G); also elsewhere on the board
/CH30: Q330.1 (G); also elsewhere on the board
/CONT: D302.2, R306.1, TP303.1; also elsewhere on the board
/CONT_EN: D301.2, R304.2, TP301.1; also elsewhere on the board
/firing/BUS: C305.1, D303.2 (A), L301.1, P301.1, P302.1, P303.1, P304.1, P305.1, P306.1, P307.1, P308.1, P309.1, P310.1, P311.1, P312.1, P313.1, P314.1, P315.1, P316.1, P317.1, P318.1, P319.1, P320.1, P321.1, P322.1, P323.1, P324.1, P325.1, P326.1, P327.1, P328.1, P329.1, P330.1, R304.1, R306.2
/firing/RETURN: C305.2, Q301.2 (S), Q302.2 (S), Q303.2 (S), Q304.2 (S), Q305.2 (S), Q306.2 (S), Q307.2 (S), Q308.2 (S), Q309.2 (S), Q310.2 (S), Q311.2 (S), Q312.2 (S), Q313.2 (S), Q314.2 (S), Q315.2 (S), Q316.2 (S), Q317.2 (S), Q318.2 (S), Q319.2 (S), Q320.2 (S), Q321.2 (S), Q322.2 (S), Q323.2 (S), Q324.2 (S), Q325.2 (S), Q326.2 (S), Q327.2 (S), Q328.2 (S), Q329.2 (S), Q330.2 (S), R307.1, R308.1
GND: C301.2, C302.2, C303.2, D304.2 (A), IC301.9 (GND), IC301.EP (GND), R302.2, R305.2, R308.2, R309.2; also elsewhere on the board
unnamed: C302.1, IC301.6 (IADJ), R303.1
unnamed: C303.1, IC301.8 (COMP)
unnamed: C304.1, IC301.1 (BOOT)
unnamed: C304.2, D304.1 (K), IC301.10 (PH), L301.2
unnamed: IC301.3 (UVLO), R301.2, R302.1
unnamed: IC301.5 (RT/CLK), R305.1
unnamed: IC301.7 (ISENSE), R307.2
unnamed: P301.2, Q301.3 (D)
unnamed: P302.2, Q302.3 (D)
unnamed: P303.2, Q303.3 (D)
unnamed: P304.2, Q304.3 (D)
unnamed: P305.2, Q305.3 (D)
unnamed: P306.2, Q306.3 (D)
unnamed: P307.2, Q307.3 (D)
unnamed: P308.2, Q308.3 (D)
unnamed: P309.2, Q309.3 (D)
unnamed: P310.2, Q310.3 (D)
unnamed: P311.2, Q311.3 (D)
unnamed: P312.2, Q312.3 (D)
unnamed: P313.2, Q313.3 (D)
unnamed: P314.2, Q314.3 (D)
unnamed: P315.2, Q315.3 (D)
unnamed: P316.2, Q316.3 (D)
unnamed: P317.2, Q317.3 (D)
unnamed: P318.2, Q318.3 (D)
unnamed: P319.2, Q319.3 (D)
unnamed: P320.2, Q320.3 (D)
unnamed: P321.2, Q321.3 (D)
unnamed: P322.2, Q322.3 (D)
unnamed: P323.2, Q323.3 (D)
unnamed: P324.2, Q324.3 (D)
unnamed: P325.2, Q325.3 (D)
unnamed: P326.2, Q326.3 (D)
unnamed: P327.2, Q327.3 (D)
unnamed: P328.2, Q328.3 (D)
unnamed: P329.2, Q329.3 (D)
unnamed: P330.2, Q330.3 (D)

Notes on the sheet:
Schottkys clamp firing voltage to 3v3 to protect inputs 3k3 sets cont current to 3.3V / 3.3kR = 1mA and limits clamp current to (12-3.3)V / 3.3kR = 3mA

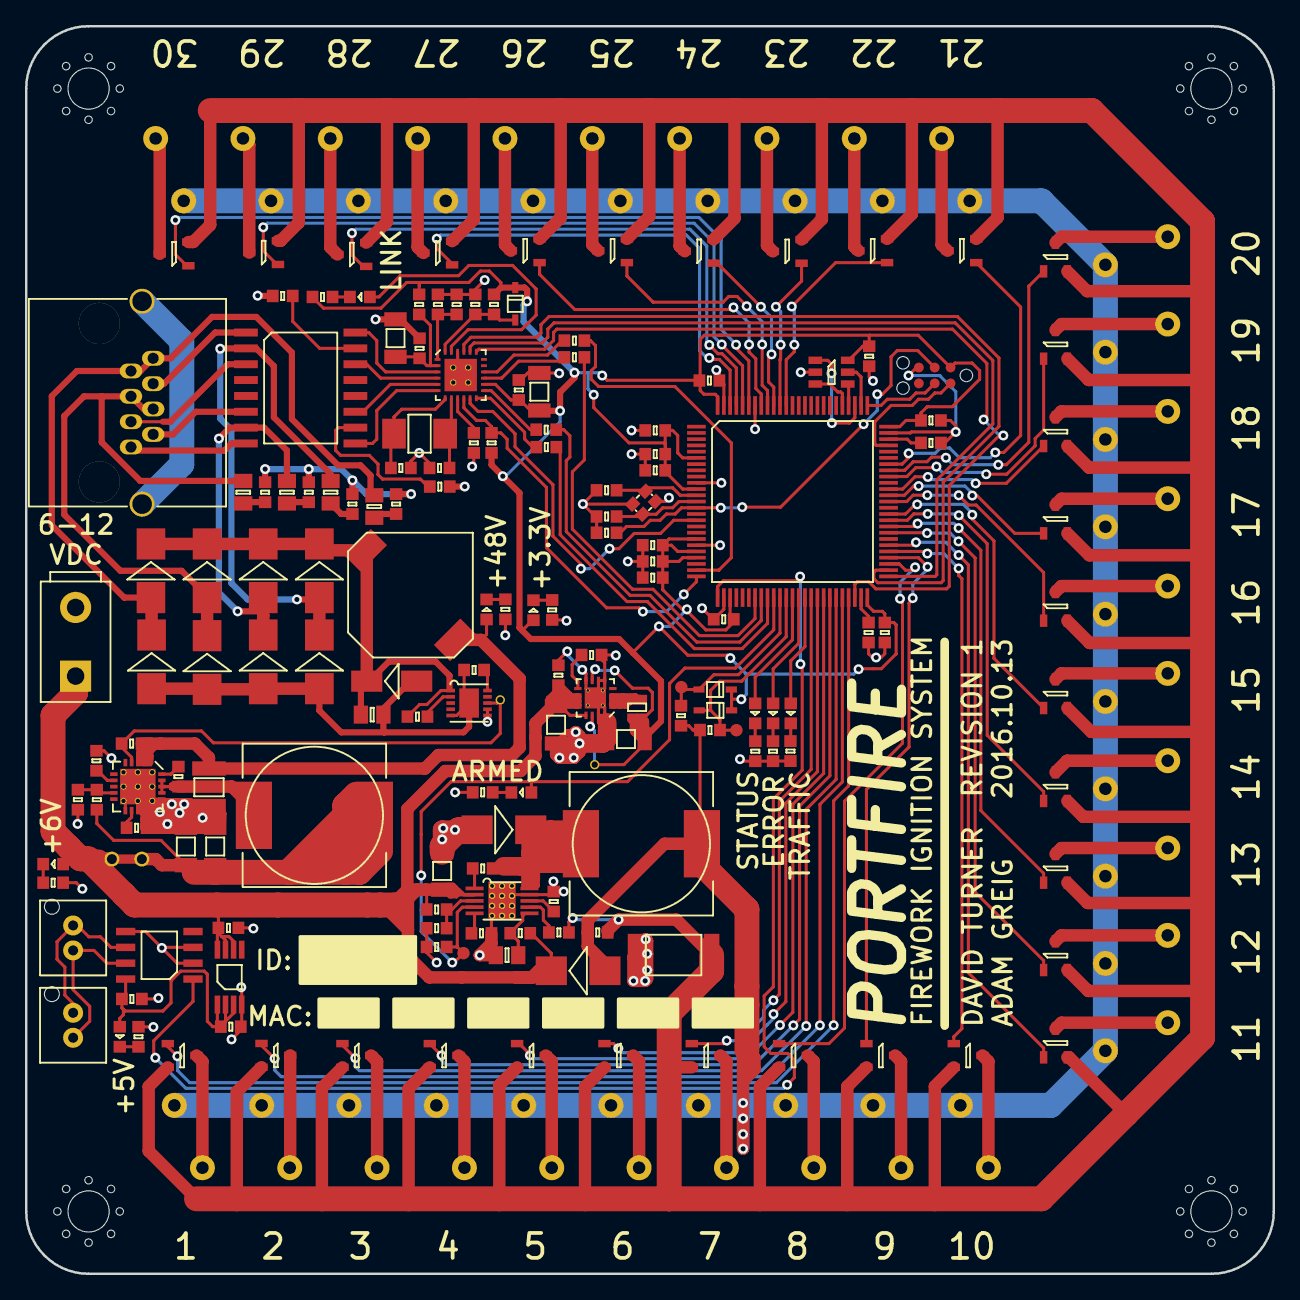
[picture p31: board portfire.kicad_pcb from above]

Board: 2 copper layers, 100.0 x 100.0 mm, 199 parts (0 on the bottom side), 154 nets.
