cillian64/portfire/firmware/firing.c

#include <string.h>

#include "firing.h"
#include "ch.h"
#include "hal.h"

#define NUM_CHANNELS (30)
#define FIRING_TIME_MS (1000)

/* Map channel numbers to IO lines. */
static ioline_t channel_map[NUM_CHANNELS + 1] = {
    0,
    LINE_CH1, LINE_CH2, LINE_CH3, LINE_CH4, LINE_CH5,
    LINE_CH6, LINE_CH7, LINE_CH8, LINE_CH9, LINE_CH10,
    LINE_CH11, LINE_CH12, LINE_CH13, LINE_CH14, LINE_CH15,
    LINE_CH16, LINE_CH17, LINE_CH18, LINE_CH19, LINE_CH20,
    LINE_CH21, LINE_CH22, LINE_CH23, LINE_CH24, LINE_CH25,
    LINE_CH26, LINE_CH27, LINE_CH28, LINE_CH29, LINE_CH30
};

/* ADC configuration. */
static const ADCConversionGroup adc_grp = {
    .circular = false,
    .num_channels = 1,
    .end_cb = NULL,
    .error_cb = NULL,
    .cr1 = 0,
    .cr2 = ADC_CR2_SWSTART,
    .smpr1 = 0,
    .smpr2 = ADC_SMPR2_SMP_AN9(ADC_SAMPLE_480),
    .sqr1 = ADC_SQR1_NUM_CH(1),
    .sqr2 = 0,
    .sqr3 = ADC_SQR3_SQ1_N(ADC_CHANNEL_IN9),
};

/* Lock used between API and internal thread. */
static MUTEX_DECL(firing_lock);

/* Semaphore to signal firing thread to use a set of firing channels. */
static BSEMAPHORE_DECL(firing_sem, false);

/******************************************************************************
 * ARMING
 */
static bool armed = false;

void firing_arm()
{
    chMtxLock(&firing_lock);
    armed = true;
    palSetLine(LINE_ARM);
    chMtxUnlock(&firing_lock);
}

void firing_disarm()
{
    chMtxLock(&firing_lock);
    armed = false;
    palClearLine(LINE_ARM);
    chMtxUnlock(&firing_lock);
}

bool firing_armed()
{
    return armed;
}

/******************************************************************************
 * FIRING
 */

/* Firing thread */
static uint8_t firing_channels[3] = {0};
static THD_WORKING_AREA(firing_thd_wa, 128);
static THD_FUNCTION(firing_thd, arg)
{
    (void)arg;
    int i;
    systime_t start;

    while(true) {

        /* Wait to be signalled that it's time to fire. */
        chBSemWait(&firing_sem);

        /* Acquire the firing mutex for the firing duration. */
        chMtxLock(&firing_lock);

        /* Fire for the hardcoded firing duration. */
        start = chVTGetSystemTime();
        while(chVTTimeElapsedSinceX(start) < MS2ST(FIRING_TIME_MS)) {
            /* Loop through up to three channels to fire simultaneously. */
            for(i=0; i<3; i++) {
                if(armed && firing_channels[i] != 0) {
                    /* Send 10ms pulse of firing current into channel. */
                    palSetLine(channel_map[firing_channels[i]]);
                    chThdSleepMilliseconds(10);
                    palClearLine(channel_map[firing_channels[i]]);
                } else {
                    /* Delay when not firing in this time slot */
                    chThdSleepMilliseconds(10);
                }
            }
        }

        chMtxUnlock(&firing_lock);
    }
}

void firing_fire(uint8_t a, uint8_t b, uint8_t c)
{
    /* Do nothing if any channel is invalid. */
    if(a > NUM_CHANNELS || b > NUM_CHANNELS || c > NUM_CHANNELS) {
        return;
    }

    /* Acquire the firing mutex.
     * This will block until any existing firing operation is completed.
     */
    chMtxLock(&firing_lock);

    /* Update the set of channels to be firing. */
    firing_channels[0] = a;
    firing_channels[1] = b;
    firing_channels[2] = c;

    /* Signal the firing thread to begin firing. */
    chBSemSignal(&firing_sem);

    chMtxUnlock(&firing_lock);
}

void firing_init()
{
    chThdCreateStatic(firing_thd_wa, sizeof(firing_thd_wa), NORMALPRIO,
                      firing_thd, NULL);
}

uint16_t firing_bus_voltage()
{
    adcsample_t samp;

    chMtxLock(&firing_lock);

    /* Take an ADC reading */
    adcStart(&ADCD1, NULL);
    chThdSleepMilliseconds(100);
    adcConvert(&ADCD1, &adc_grp, &samp, 1);
    adcStop(&ADCD1);

    chMtxUnlock(&firing_lock);

    /* Convert to a voltage */
    return (uint16_t)((float)samp * (3300.0f / 4096.0f));
}

/******************************************************************************
 * CONTINUITY
 */
/* Probably 0.1 ohms... */
static uint8_t adc_to_resistance(adcsample_t reading, adcsample_t cal) {
    float r;

    if(reading < cal) {
        return 0;
    }

    reading -= cal;
    r = (3300.0f * (float)reading) / (4096.0f - (float)reading);

    if(r >= 255.0f) {
        return 255;
    } else {
        return (uint8_t)r;
    }
}

void firing_cont(uint8_t* channels)
{
    int i;
    adcsample_t cal;
    adcsample_t samp;

    chMtxLock(&firing_lock);

    /* Return all 0s if we're currently armed. */
    if(armed) {
        memset((void*)channels, 0, 30);
        chMtxUnlock(&firing_lock);
        return;
    }

    /* Start the ADC */
    adcStart(&ADCD1, NULL);

    /* Ensure the firing current is disabled. */
    palClearLine(LINE_ARM);

    /* Calibrate the clamp diode reverse leakage current. */
    palClearLine(LINE_CONT_EN);
    chThdSleepMilliseconds(10);
    adcConvert(&ADCD1, &adc_grp, &cal, 1);
    cal /= 2;

    /* Enable the continuity test current. */
    palSetLine(LINE_CONT_EN);

    for(i=1; i<=NUM_CHANNELS; i++) {
        palSetLine(channel_map[i]);
        chThdSleepMilliseconds(10);
        adcConvert(&ADCD1, &adc_grp, &samp, 1);
        channels[i-1] = adc_to_resistance(samp, cal);
        palClearLine(channel_map[i]);
    }

    /* Measure bus voltage with no channels active. */
    chThdSleepMilliseconds(10);
    adcConvert(&ADCD1, &adc_grp, &samp, 1);
    channels[NUM_CHANNELS] = (uint8_t)((float)samp * (33.0f / 4096.0f));

    /* Disable continuity test current. */
    palClearLine(LINE_CONT_EN);

    /* Stop the ADC */
    adcStop(&ADCD1);

    chMtxUnlock(&firing_lock);
}
