cillian64/portfire/firmware/net.c

#include <string.h>

#include "ch.h"

#include "net.h"
#include "firing.h"

#include "lwip/opt.h"
#include "lwip/arch.h"
#include "lwip/api.h"
#include "lwip/netif.h"

#define NET_PORT (9090)

static const char net_ok_msg[] = "OK\r\n";

static void net_handle_continuity(struct netconn *conn)
{
    uint8_t channels[31];
    firing_cont(channels);
    netconn_write(conn, channels, sizeof(channels), NETCONN_COPY);
}

static void net_handle_arm(struct netconn *conn)
{
    firing_arm();
    netconn_write(conn, net_ok_msg, sizeof(net_ok_msg)-1, NETCONN_NOCOPY);
}

static void net_handle_disarm(struct netconn *conn)
{
    firing_disarm();
    netconn_write(conn, net_ok_msg, sizeof(net_ok_msg)-1, NETCONN_NOCOPY);
}

static void net_handle_bus_voltage(struct netconn *conn)
{
    uint16_t v = firing_bus_voltage();
    netconn_write(conn, &v, sizeof(v), NETCONN_COPY);
}

static void net_handle_ping(struct netconn *conn)
{
    netconn_write(conn, net_ok_msg, sizeof(net_ok_msg)-1, NETCONN_NOCOPY);
}

static void net_handle_fire(struct netconn *conn, uint8_t* channels)
{
    firing_fire(channels[0], channels[1], channels[2]);
    netconn_write(conn, net_ok_msg, sizeof(net_ok_msg)-1, NETCONN_NOCOPY);
}

static void net_handle(struct netconn *conn)
{
    struct netbuf *inbuf;
    uint8_t *buf;
    uint16_t buflen;
    err_t err;

    /* Read data from the port, blocking if there's no data to receive.
     * This will only read one netbuf, but hopefully all our requests fit
     * inside one netbuf.
     */
    err = netconn_recv(conn, &inbuf);

    if(err != ERR_OK) {
        goto cleanup;
    }

    /* Get a pointer to the netbuf's data, and its length */
    netbuf_data(inbuf, (void**)&buf, &buflen);

    if(buflen == 0) {
        goto cleanup;
    }

    if(buf[0] == 'c') {
        net_handle_continuity(conn);
    } else if(buf[0] == 'a') {
        net_handle_arm(conn);
    } else if(buf[0] == 'd') {
        net_handle_disarm(conn);
    } else if(buf[0] == 'b') {
        net_handle_bus_voltage(conn);
    } else if(buf[0] == 'p') {
        net_handle_ping(conn);
    } else if(buf[0] == 'f') {
        if(buflen >= 4) {
            net_handle_fire(conn, buf+1);
        }
    }

    /* Close the connection and clean up the buffer. */
cleanup:
    netconn_close(conn);
    netbuf_delete(inbuf);
}

static THD_WORKING_AREA(net_thd_wa, 1024);
static THD_FUNCTION(net_thd, arg)
{
    (void)arg;

    struct netconn *conn, *newconn;
    err_t err;

    /* Create new TCP connection handle */
    conn = netconn_new(NETCONN_TCP);
    LWIP_ERROR("net: invalid conn", (conn != NULL), chThdExit(MSG_RESET););

    /* Bind to port NET_PORT on default IP address */
    netconn_bind(conn, NULL, NET_PORT);

    /* Start listening to connection */
    netconn_listen(conn);

    /* Serve requests */
    while(true) {
        err = netconn_accept(conn, &newconn);
        if(err != ERR_OK) {
            continue;
        }

        palSetLine(LINE_TRAFFIC);
        net_handle(newconn);
        palClearLine(LINE_TRAFFIC);
        netconn_delete(newconn);
    }
}

struct autodiscovery_packet {
    char magic[8];
    uint32_t ip;
    uint8_t mac[6];
};

static char autodiscovery_magic[8] = "PORTFIRE";

static void fill_autodiscovery_packet(struct autodiscovery_packet* pkt)
{
    memcpy(pkt->magic, autodiscovery_magic, sizeof(autodiscovery_magic));
    pkt->ip = netif_default->ip_addr.addr;
    pkt->mac[0] = netif_default->hwaddr[0];
    pkt->mac[1] = netif_default->hwaddr[1];
    pkt->mac[2] = netif_default->hwaddr[2];
    pkt->mac[3] = netif_default->hwaddr[3];
    pkt->mac[4] = netif_default->hwaddr[4];
    pkt->mac[5] = netif_default->hwaddr[5];
}

static THD_WORKING_AREA(autodiscovery_thd_wa, 1024);
static THD_FUNCTION(autodiscovery_thd, arg)
{
    (void)arg;

    struct netconn *conn;
    struct netbuf *buf;
    struct autodiscovery_packet pkt;
    void* buf_data;

    conn = netconn_new(NETCONN_UDP);
    LWIP_ERROR("net: invalid conn", (conn != NULL), chThdExit(MSG_RESET););

    netconn_bind(conn, IP_ADDR_ANY, NET_PORT+1);
    netconn_connect(conn, IP_ADDR_BROADCAST, NET_PORT);

    while(true) {
        palSetLine(LINE_TRAFFIC);
        fill_autodiscovery_packet(&pkt);
        buf = netbuf_new();
        buf_data = netbuf_alloc(buf, sizeof(struct autodiscovery_packet));
        memcpy(buf_data, (void*)&pkt, sizeof(struct autodiscovery_packet));
        netconn_send(conn, buf);
        netbuf_delete(buf);
        palClearLine(LINE_TRAFFIC);

        chThdSleepMilliseconds(1000);
    }
}

void net_init()
{
    chThdCreateStatic(net_thd_wa, sizeof(net_thd_wa), NORMALPRIO, net_thd, 0);
    chThdCreateStatic(autodiscovery_thd_wa, sizeof(autodiscovery_thd_wa),
                      NORMALPRIO, autodiscovery_thd, 0);
}
