cillian64/portfire/firmware/firing.h

#ifndef PORTFIRE_FIRING_H
#define PORTFIRE_FIRING_H

#include <stdint.h>
#include <stdbool.h>

/* Arm/disarm the firing circuits.
 */
void firing_arm(void);
void firing_disarm(void);
bool firing_armed(void);

/* Set up to three channels to fire.
 *
 * Will fire for a fixed duration; if you call firing_fire again
 * before this expires then it will block until the initial firing is complete.
 *
 * Set parameters to 0 to fire fewer than three channels.
 */
void firing_fire(uint8_t ch_a, uint8_t ch_b, uint8_t ch_c);

/* Reports continuity on all channels.
 *
 * CAN ONLY BE USED WHILE DISARMED. Reports all 0s if called while armed.
 * `channels` is written with 31 bytes.
 *
 * The first 30 entries are channel resistances in ohms, 0-254, or "high
 * impedance", 255. The final entry is the bus voltage (in 0.1V/LSb) with
 * continuity testing enabled but no channels are being sensed:
 * this should be 3.3V unless a fault is causing a channel to conduct,
 * causing the voltage to drop to 0, in which case don't arm the system.
 *
 * Each channel is written with an approximate resistance in ohms.
 */
void firing_cont(uint8_t* channels);

/* Reads firing bus voltage, in millivolts.
 *
 * On the whole this should be near 0 when disarmed and near 3300 when armed,
 * since we clamp to 3.3V in hardware.
 */
uint16_t firing_bus_voltage(void);

/* Initialise the firing system.
 * Spawns a thread to perform firing operations.
 */
void firing_init(void);

#endif
