cillian64/portfire/(commit log)

2016-09-19 Add firing block connector footprint
2016-09-20 Added wire terminal part
    [portfire.kicad_pcb, portfire.sch]
2016-09-21 PoE and switcher BOM
2016-09-21 inductor footprints
2016-09-25 Added agg-kicad submodule
2016-09-26 Roughed out ethernet part of schematic
    [portfire.sch]
2016-09-29 Added lots of component specs around poe section
    [portfire.sch]
2016-10-01 SMPS schematic design
    [portfire.sch]
2016-10-01 Added SMPS inductor footprint
    [portfire.sch]
2016-10-01 Fixed fp references
    [portfire.kicad_pcb, portfire.sch]
2016-10-01 Hierarchical sheets, connected up RMII/PD pins
    [ethernet.sch, portfire.kicad_pcb, portfire.sch]
2016-10-01 Added 3v3 sync buck smps
    [ethernet.sch, portfire.sch]
2016-10-01 stm32 psu and SWD programming
    [ethernet.sch, portfire.sch]
2016-10-01 Added firing switch transistors
    [ethernet.sch, firing.sch, portfire.sch]
2016-10-02 Firing matrix and CC SMPS
    [ethernet.sch, firing.sch, portfire.kicad_pcb, portfire.sch]
2016-10-03 aux power, test points
    [ethernet.sch, firing.sch, portfire.kicad_pcb, portfire.sch]
2016-10-04 bump agg-kicad
2016-10-04 Added aux bus
    [ethernet.sch, firing.sch, portfire.kicad_pcb, portfire.sch]
2016-10-04 Fixed schematic part with derpy path
    [ethernet.sch, firing.sch, portfire.sch]
2016-10-04 LEDs, ethernet jack
    [ethernet.sch, firing.sch, portfire.kicad_pcb, portfire.sch]
2016-10-04 component grouping on pcb sheet
    [portfire.kicad_pcb]
2016-10-04 mounting holes
    [portfire.kicad_pcb, portfire.sch]
2016-10-06 Added xtal to STM32
    [ethernet.sch, firing.sch, portfire.kicad_pcb, portfire.sch]
2016-10-06 Routed STM32 cruft and started on ethernet
    [portfire.kicad_pcb]
2016-10-11 various routing
    [ethernet.sch, firing.sch, portfire.kicad_pcb]
2016-10-11 Moved Bob Smith from signal gnd to chassis gnd
    [ethernet.sch]
2016-10-11 Invert ethernet magnetics ordering.
    [ethernet.sch, firing.sch, portfire.kicad_pcb, portfire.sch]
2016-10-11 Removed pointless half of Bob Smith
    [ethernet.sch, firing.sch, portfire.kicad_pcb]
2016-10-12 Lots of placement/routing
    [ethernet.sch, firing.sch, portfire.kicad_pcb, portfire.sch]
2016-10-12 Placed uc, routed RMII
    [ethernet.sch, firing.sch, portfire.kicad_pcb, portfire.sch]
2016-10-12 Routed ROM
    [portfire.kicad_pcb, portfire.sch]
2016-10-12 Routed cont, arm, LEDs
    [ethernet.sch, firing.sch, portfire.kicad_pcb, portfire.sch]
2016-10-12 Routed firing channels
    [portfire.kicad_pcb, portfire.sch]
2016-10-12 LED labels
    [portfire.kicad_pcb]
2016-10-13 Rotate silk labels on CH21-30
    [portfire.kicad_pcb]
2016-10-13 Shrank ethernet jack pins, beefed PD tracks
    [portfire.kicad_pcb]
2016-10-13 Fixed ERC and DRC issues
    [ethernet.sch, firing.sch, portfire.kicad_pcb, portfire.sch]
2016-10-13 Made board beautiful
    [portfire.kicad_pcb]
2016-10-13 add some 3d models, render
    [portfire.kicad_pcb]
2016-10-13 Schematic sheet annotation
    [ethernet.sch, firing.sch, portfire.sch]
2016-10-13 update cap models to capacitors
    [portfire.kicad_pcb]
2016-10-14 make pcb work with kicad 4.0.4 again
    [portfire.kicad_pcb]
2016-10-14 update 5v ldo to correct farnell part
    [portfire.sch]
2016-10-14 add pulldown to ARM line
    [ethernet.sch, firing.sch, portfire.kicad_pcb, portfire.sch]
2016-10-14 remove power schematic sheet pins
    [ethernet.sch, firing.sch, portfire.sch]
2016-10-15 connect link led to 3v3 not gnd, and sign-off schematic
    [ethernet.sch, firing.sch, portfire.kicad_pcb, portfire.sch]
2016-10-15 add bom from script
2016-10-15 board tidy-up
    [portfire.kicad_pcb]
2016-10-15 make board work in kicad 4.0.4
    [portfire.kicad_pcb]
2016-10-15 Reduced silk linewidth slightly
    [portfire-B.Cu.gbl, portfire-B.Mask.gbs, portfire-B.SilkS.gbo, portfire-Edge.Cuts.gm1, portfire-F.Cu.gtl, portfire-F.Mask.gts, portfire-F.Paste.gtp, portfire-F.SilkS.gto]
2016-10-16 Removed paste from gerber zip
2016-10-17 rename edge cuts gerber
2016-10-19 swap to f417
    [portfire.sch]
2016-11-07 Changed LAN magnetics to PoE compat part
    [ethernet.sch]
2016-11-09 Added BOM/stickerbom docs
    [portfire_bom.ods]
2016-11-11 add continuity calibration and 3-at-once firing
2016-11-11 Fix multiple firing, fix board.h error, add bus voltage reading
    [board.h, firing.c, firing.h, main.c]
2016-11-11 Added first attempt at case
    [base_plate.SLDPRT, case_assembled.SLDASM, hex_pillar.SLDPRT, pcb.SLDPRT, side_1-10_and_21-30.SLDPRT, side_11-20.SLDPRT, side_ethernet.SLDPRT, spacer.SLDPRT]
2016-11-11 renamed case to castellated.
    [base_plate.SLDPRT, case_assembled.SLDASM, hex_pillar.SLDPRT, pcb.SLDPRT, side_1-10_and_21-30.SLDPRT, side_11-20.SLDPRT, side_ethernet.SLDPRT, spacer.SLDPRT]
2016-11-11 Added new hinged case design
    [base_plate.SLDPRT, case_assembled.SLDASM, hex_pillar.SLDPRT, hinged_lid.SLDPRT, pcb.SLDPRT, side_1-10_and_21-30.SLDPRT, side_11-20.SLDPRT, side_ethernet.SLDPRT]
2016-11-15 add continuity bus voltage sensing
2016-11-16 added hinged case plots and hinge
    [base_plate.DXF, case_assembled.SLDASM, hinged_lid.DXF, hinged_lid.SLDPRT, side_1-10_and_21-30.DXF, side_11-20.DXF, side_ethernet.DXF, top_plate.DXF]
